Ben-BJD/Pixel-Tree-Controller/BOM.csv

Reference | Qty | Value | DNP | Exclude from BOM | Exclude from Board | Footprint | Datasheet | Manufacturer | Manufacturer Part | Supplier | Supplier Part | Description
C1 | 1 | 0.1uf |  |  |  | easyeda2kicad:C0805 | https://lcsc.com/product-detail/Multilayer-Ceramic-Capacitors-MLCC-SMD-SMT_C0805B104K500NT_C476766.html
C2 | 1 | 1000uF |  |  |  | Custom:CAP-TH_BD12.5-P5.00-D0.6-FD | https://www.lcsc.com/product-detail/C88743.html | rubycon(红宝石) | 35YXJ1000M12.5X20 | LCSC | C88743
CN1,CN2,CN3,CN4,CN5,CN6,CN7,CN8 | 8 | KF2EDGR-5.08-3P |  |  |  | Custom:CONN-TH_3P-P5.08_KF2EDGR-5.08-3P | https://www.lcsc.com/product-detail/C441205.html | KEFA(科发) | KF2EDGR-5.08-3P | LCSC | C441205
FH1,FH2,FH3,FH4,FH5,FH6,FH7,FH8 | 8 | XF-506P |  |  |  | Custom:FUSE-TH_XF-506P | https://www.lcsc.com/product-detail/C492610.html | XFCN(兴飞) | XF-506P | LCSC | C492610
H1,H2,H3,H4 | 4 | MountingHole |  | Excluded from BOM |  | MountingHole:MountingHole_3.2mm_M3 | ~ |  |  |  |  | Mounting Hole without connection
N1 | 1 | PTR-28483 |  |  | Excluded from board |  | https://www.digikey.com.au/en/products/detail/bud-industries/PTR-28483/17765877 | Bud Industries | PTR-28483 | DigiKey | 377-PTR-28483-ND | BOX ABS LGT GRY 8.6"L X 6.3"W
N2 | 1 | 5308 513/SET |  |  | Excluded from board |  | https://www.digikey.com.au/en/products/detail/altech-corporation/5308-513-SET/21378714 | Altech Corporation | 5308 513/SET | DigiKey | 1920-5308513/SET-ND | Cable Gland Polyamide (PA), Nylon PG13.5 Black
N3 | 1 | 5309 211/SET |  |  | Excluded from board |  | https://www.digikey.com.au/en/products/detail/altech-corporation/5309-211-SET/21378705 | Altech Corporation | 5309 211/SET | DigiKey | 1920-5309211/SET-ND | Cable Gland Polyamide (PA6), Nylon 6 PG11 Black
N4,N5,N6,N7,N8,N9,N10,N11 | 8 | 5308 509/SET |  |  | Excluded from board |  | https://www.digikey.com.au/en/products/detail/altech-corporation/5308-509-SET/21378710 | Altech Corporation | 5308 509/SET | DigiKey | 1920-5308509/SET-ND | Cable Gland Polyamide (PA), Nylon PG9 Black
N12 | 1 | ESP32-S3-DevKitC-1-N8R8 |  |  | Excluded from board |  | https://au.mouser.com/en/ProductDetail/Espressif-Systems/ESP32-S3-DevKitC-1-N8R8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 | Espressif Systems | ESP32-S3-DevKitC-1-N8R8 | Mouser | 356-EP32S3DVKTC1N8R8 | WiFi Development Tools - 802.11 ESP32-S3 general-purpose development board, embeds ESP32-S3-WROOM-1, 8 MB Quad flash and 8MB Octal PSRAM, with pin header
N13,N14,N15,N16,N17,N18,N19,N20 | 8 | KF2EDGK-5.08-3P-AA |  |  | Excluded from board |  | https://www.lcsc.com/product-detail/C440881.html | Cixi Kefa Elec | KF2EDGK-5.08-3P-AA | LCSC | C440881 | TERM BLOCK PLUG 3POS 5.08mm
RN1 | 1 | 33Ω |  |  |  | Custom:RES-ARRAY-SMD_16P-L3.8-W1.6-P0.50-BL | https://www.lcsc.com/product-detail/C713459.html | PANASONIC(松下) | EXB2HV330JV | LCSC | C713459
U2,U3 | 2 | ZX-PM2.54-1-22PY |  |  |  | Custom:HDR-TH_22P-P2.54-V-F | https://www.lcsc.com/product-detail/C7499337.html | Megastar(兆星) | ZX-PM2.54-1-22PY | LCSC | C7499337
U4 | 1 | SN74HCT245PWR |  |  |  | Custom:TSSOP-20_L6.5-W4.4-P0.65-LS6.4-BL | https://www.lcsc.com/product-detail/C6779.html | TI(德州仪器) | SN74HCT245PWR | LCSC | C6779
U5 | 1 | K7805-1000R3_C2992391 |  |  |  | Custom:PWRM-TH_YLPTEC_K78XX-1000R3 | https://www.lcsc.com/product-detail/C2992391.html | YLPTEC(易川) | K7805-1000R3 | LCSC | C2992391
U6 | 1 | HB9500-9.5-2P |  |  |  | Custom:CONN-TH_HB9500-9.5-2P | https://www.lcsc.com/product-detail/C707836.html | KEFA(科发) | HB9500-9.5-2P | LCSC | C707836
