Ben-BJD/Pixel-Tree-Controller/Pixel-Tree-Controller-Schematic.pdf

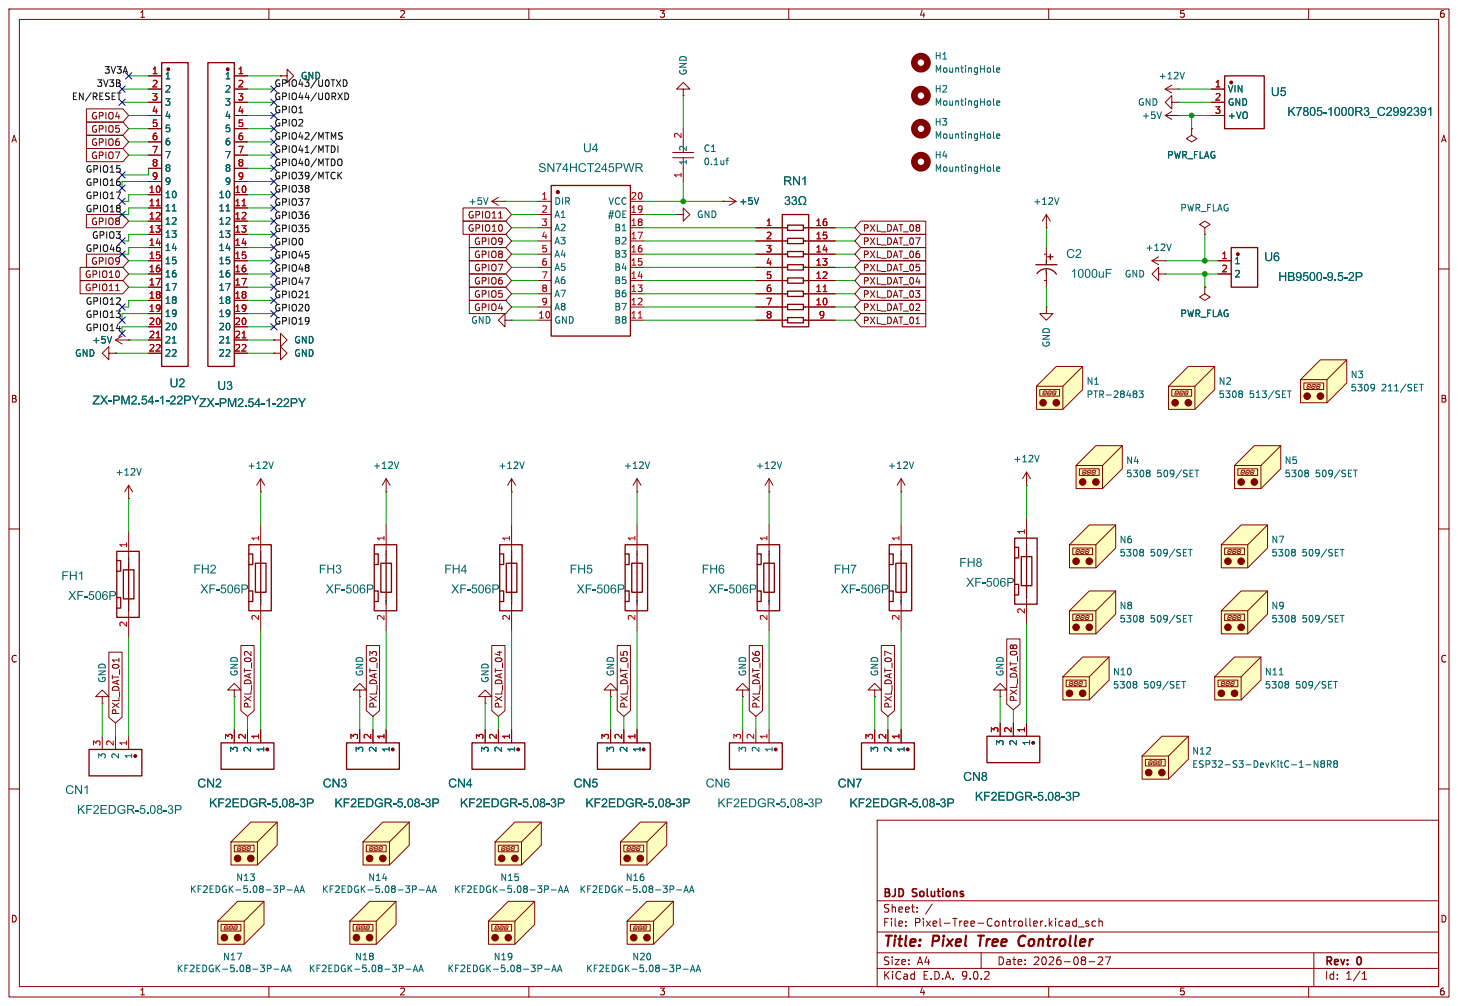
[picture p7: page 1]

Id: 1/1 Title: Pixel Tree Controller File: Pixel-Tree-Controller.kicad_sch Sheet: / BJD Solutions
