Ben-BJD/Pixel-Tree-Controller/Pixel-Tree-Controller.kicad_pcb

## KiCad design Pixel-Tree-Controller.kicad_pcb (2026-10-10)

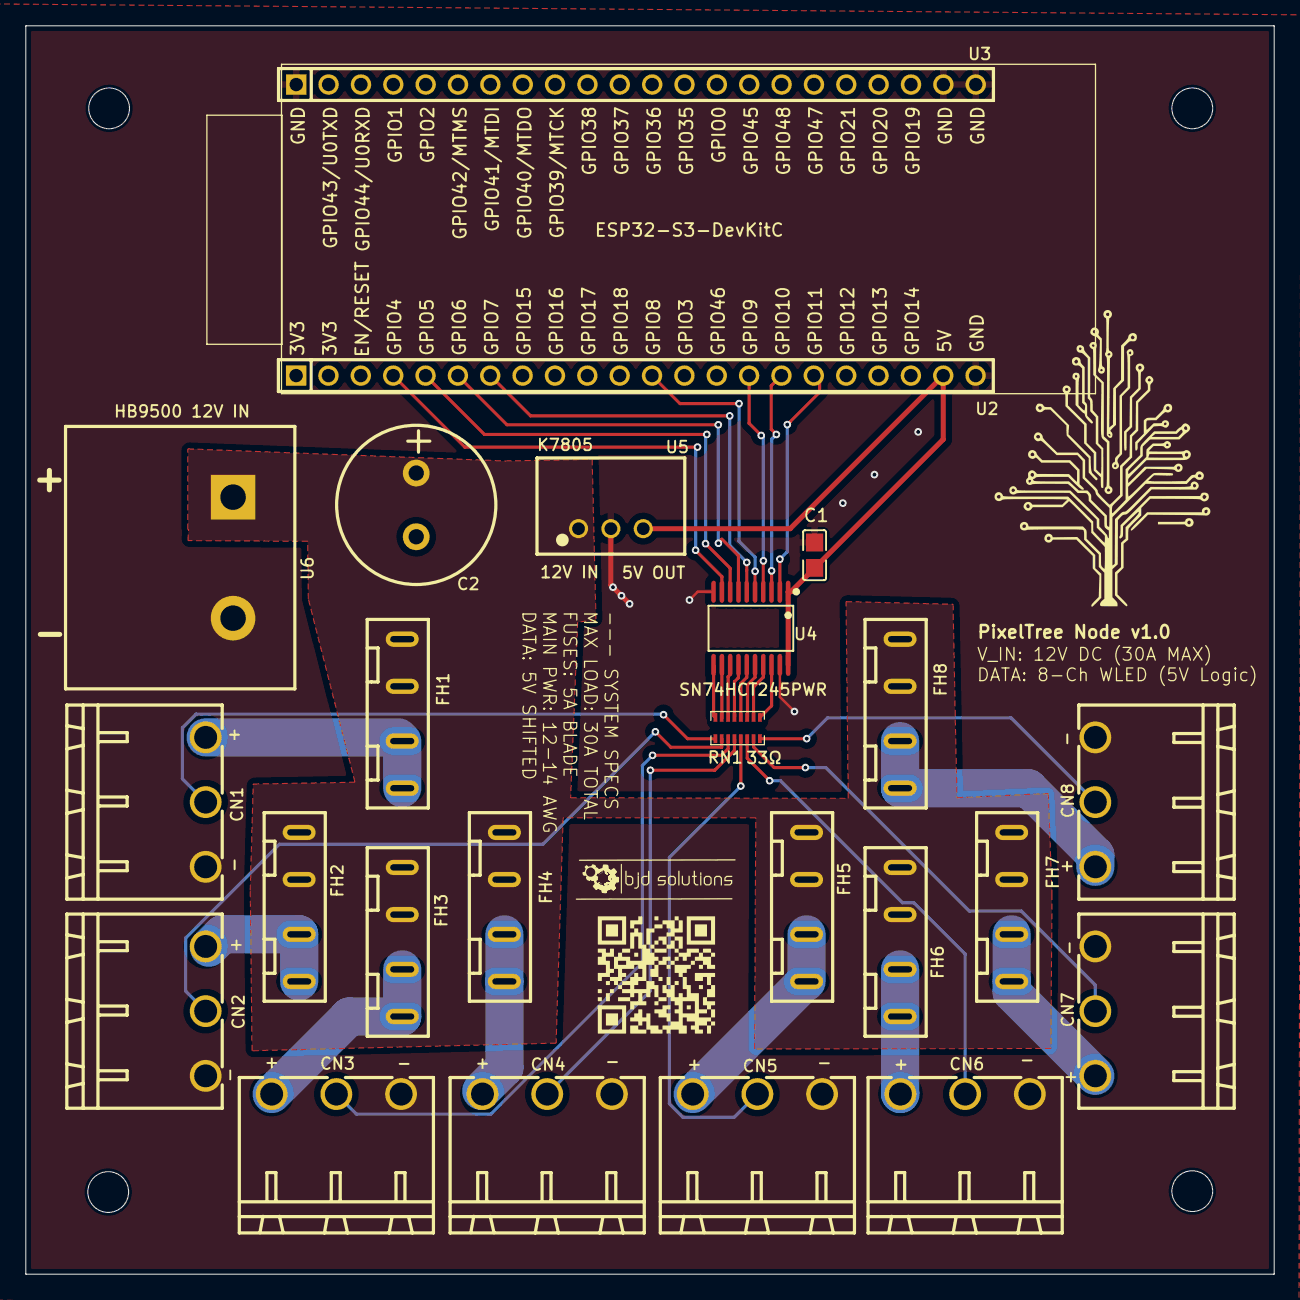
[picture p8: board Pixel-Tree-Controller.kicad_pcb from above]

Board: 2 copper layers, 98.0 x 98.0 mm, 28 parts (0 on the bottom side), 35 nets.

Parts:
C1: 0.1uf; C0805
C2: 1000uF; CAP-TH_BD12.5-P5.00-D0.6-FD
CN1, CN2, CN3, CN4, CN5, CN6, CN7, CN8: KF2EDGR-5.08-3P; CONN-TH_3P-P5.08_KF2EDGR-5.08-3P
FH1, FH2, FH3, FH4, FH5, FH6, FH7, FH8: XF-506P; FUSE-TH_XF-506P
H1, H2, H3, H4: MountingHole; MountingHole_3.2mm_M3
RN1: 33Ω; RES-ARRAY-SMD_16P-L3.8-W1.6-P0.50-BL
U2, U3: ZX-PM2.54-1-22PY; HDR-TH_22P-P2.54-V-F
U4: SN74HCT245PWR; TSSOP-20_L6.5-W4.4-P0.65-LS6.4-BL
U5: K7805; PWRM-TH_YLPTEC_K78XX-1000R3
U6: HB9500 12V IN; CONN-TH_HB9500-9.5-2P

Connections:
+5V: C1.1, U2.21, U4.1 (DIR), U4.20 (VCC), U5.3 (+VO)
+12V: C2.1, FH1.1, FH2.1, FH3.1, FH4.1, FH5.1, FH6.1, FH7.1, FH8.1, U5.1 (VIN), U6.1
GND: C1.2, C2.2, CN1.3, CN2.3, CN3.3, CN4.3, CN5.3, CN6.3, CN7.3, CN8.3, U2.22, U3.1, U3.21, U3.22, U4.10 (GND), U4.19 (#OE), U5.2 (GND), U6.2
GPIO4: U2.4, U4.9 (A8)
GPIO5: U2.5, U4.8 (A7)
GPIO6: U2.6, U4.7 (A6)
GPIO7: U2.7, U4.6 (A5)
GPIO8: U2.12, U4.5 (A4)
GPIO9: U2.15, U4.4 (A3)
GPIO10: U2.16, U4.3 (A2)
GPIO11: U2.17, U4.2 (A1)
unnamed: CN1.1, FH1.2
unnamed: CN2.1, FH2.2
unnamed: CN3.1, FH3.2
unnamed: CN4.1, FH4.2
unnamed: CN5.1, FH5.2
unnamed: CN6.1, FH6.2
unnamed: CN7.1, FH7.2
unnamed: CN8.1, FH8.2
unnamed: RN1.1, U4.18 (B1)
unnamed: RN1.2, U4.17 (B2)
unnamed: RN1.3, U4.16 (B3)
unnamed: RN1.4, U4.15 (B4)
unnamed: RN1.5, U4.14 (B5)
unnamed: RN1.6, U4.13 (B6)
unnamed: RN1.7, U4.12 (B7)
unnamed: RN1.8, U4.11 (B8)
PXL_DAT_01: CN1.2, RN1.9
PXL_DAT_02: CN2.2, RN1.10
PXL_DAT_03: CN3.2, RN1.11
PXL_DAT_04: CN4.2, RN1.12
PXL_DAT_05: CN5.2, RN1.13
PXL_DAT_06: CN6.2, RN1.14
PXL_DAT_07: CN7.2, RN1.15
PXL_DAT_08: CN8.2, RN1.16
