Ben-BJD/Pixel-Tree-Controller/light-test-cover.png

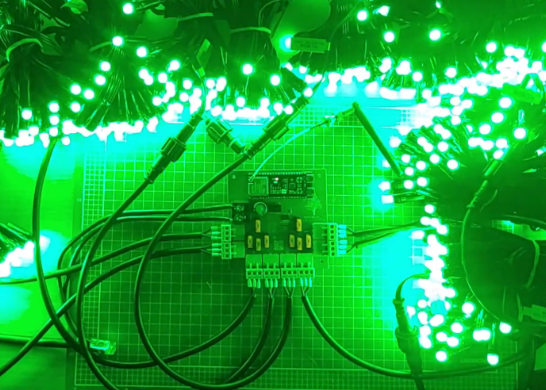
light-test-cover.png
